UVicFH/PDU2019/Capture.JPG

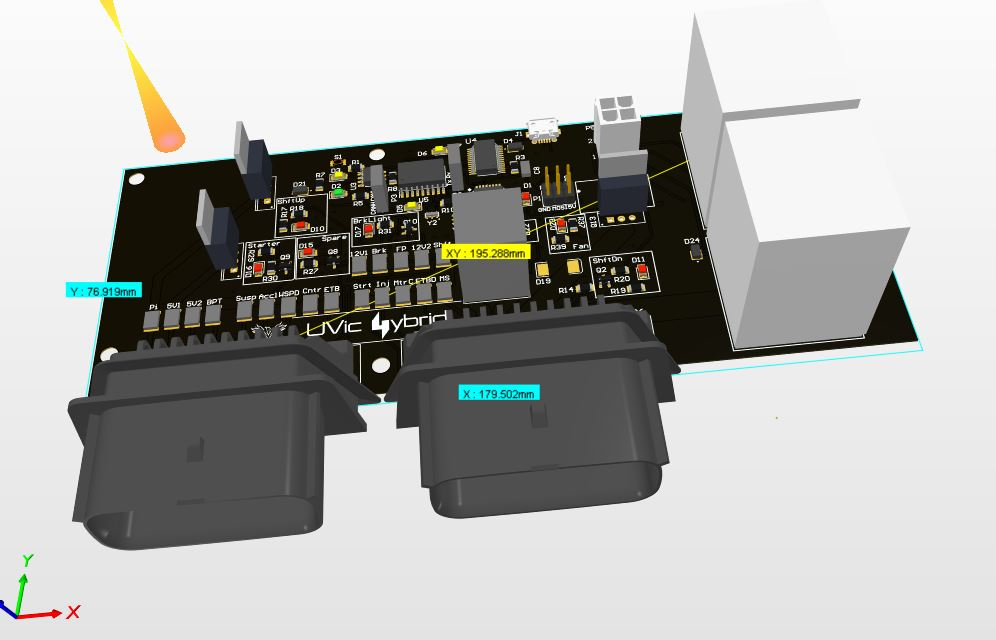
Capture.JPG
