UVicFH/PDU2019/README.md

# PDU2019
Power Distribution Unit for the 2019 vehichle
