UVicFH/PDU2019/Design Review 1 Akshdeep.rtf

PSCB file
some models are just grey boxes (fuses, relay?, caps)
mosfet models dont have legs
Green Molex?
USB has to be on edge of board for it will not sit right

High current switch
automotive relay with built in flyback diode?
does fuel pump need a flyback diode on output side?
Low current switch
the indicator leds say red on label, but part is for yellow ones (same on canduino)

Fusing
if multipe RBRB or CBRB pins are needed for current flow, the pins should be right next to one another, not spread out over two ocnnectors.
Same applies to the ground, keep it together on one connector
the layout for the connectors should be left undicided untill u make the pcb, you ma want to change the pinout to make wiring traces easier for yourself based on where you decide to put components.

IMPORTANT
The +5V net is used on the fusing and canduino files
That means that the components in the canduino are being powered before the fuse for it.
Change the +5V net in the canduino to a new net so the power flow is regulator > fuse > canduino diode > 5V
The Green led in canduino file for power indication is running at aprox 2.3mA, the resistor can be reduced a bit to bring this up to around 5-10mA.
