UVicFH/PDU2019/Power Distribution Unit 2019 BOM.xlsx

Comment | Description | Designator | Footprint | LibRef | Quantity | Supplier Part Number
1A | Fuse | 5VSpr1, 5VSpr2, 12VSpr1, 12VSpr2, BRKLTVIN, Cntrllr, ETBDrv, FP Rly, Inj, MS, Mtr Cntrl, Shft, Strt | FUSC4632X85N | Fuse 2 | 13 | 507-1878-1-ND
500mA | Fuse | ACCL, BPT, ETB, Susp, WSPD | FUSC4632X85N | Fuse 2 | 5 | 507-1876-1-ND
4.7uF | Capacitor (Semiconductor SIM Model) | C1, C5, C9, C17, C18, C19, C20 | CAPC3216X170N | Cap Semi | 7 | 1276-1055-1-ND
1uF | Capacitor (Semiconductor SIM Model) | C2, C10 | CAPC3216X170N | Cap Semi | 2 | 1276-3086-1-ND
100nF | Capacitor (Semiconductor SIM Model) | C3, C6, C7, C8 | CAPC3216X170N | Cap Semi | 4 | 1276-1151-1-ND
Cap2 | Capacitor. Ceramic 10uF 50V rating recommended, place close to pin | C4, C11, C12, C13, C14, C15, C16 | CAPC3216X170N | Cap2 | 7 | 478-8496-1-ND
Red | Typical RED LED | D1, D10, D11, D15, D16, D17, D22, D23 | LEDC3216X120NRED | LED2, LED2_2 | 8 | 732-4992-1-ND
Green | Typical GREEN LED | D2 | LEDC3216X120NGRN | LED2 | 1 | 732-4993-1-ND
Yellow | Typical YELLOW LED | D3, D5, D6, D7 | LEDC3216X120NYEL | LED2 | 4 | 732-4994-1-ND
Diode | Default Diode, Switching diode | D4, D18, D20, D21, D24 | DO-220AA | Diode | 5 | SS1P3L-M3/84AGICT-ND
Diode | Default Diode | D8, D9, D12, D13, D14 | SOD123 | Diode | 5 | BAT42W-FDICT-ND
Diode | Default Diode | D19 | SMC | Diode | 1 | S10D-TPMSCT-ND
Fuse 2 | Fuse | F1 | 1812 | Fuse 2 | 1 | ‎MF-MSMF050-2CT-ND
USB micro B | CONN SM TH USB MICRO MODIFIED FOR DRILL | J1 | 1050170001 | 1050170001 | 1 | 609-4618-1-ND
PB134012 | Miniature Power PCB Relay PB, 1 Form A Contact, 12 V, 10 A, 360 mW, Standard Version, -40 to 85 degC, 5-Pin 15 x 15 x 20 mm THD, RoHS, Tube | K1 | TECO-PB134-5_V | PB134012 | 1 | PB134012
Relay-3PDT | Reset relays | K2, K3 | 55.13 | Relay-3PDT | 2
ICSP | Header, 3-Pin, Dual row | P1 | Pin Header 2x3 TH Pitch 2.54mm | Header 3X2A | 1 | 952-2121-ND
Serial | Header, 2-Pin | P2 | Pin Header 1x2 TH Pitch 2.54mm | Header 2 | 1 | 952-2262-ND
CANOUT | Header, 2-Pin | P3 |  | Header 2 | 1 | 952-2262-ND
MX150-20 | Header, 10-Pin, Dual row | P4, P6 | MX150 20 PIN | Header 10X2 | 2 | WM12752-ND
43160-3102 | 4pin blade header molex | P5 | WM3801-ND | WM3801-ND | 1 | WM3801-ND
2A | Fuse | Pi | FUSC4632X85N | Fuse 2 | 1 | 507-1881-2-ND
MOSFET-N | N-Channel MOSFET | Q1, Q2, Q5, Q6, Q7, Q11, Q12 | SOT23-3 | MOSFET-N | 7 | SSM3K329RLFCT-ND
MOSFET-P | P-Channel MOSFET | Q3, Q4, Q8, Q9, Q10 | SOT23-3 | MOSFET-P | 5 | DMP3099L-7DICT-ND
MOSFET-P | P-Channel MOSFET | Q13 | TO-220AB | MOSFET-P | 1 | IRF4905PBF-ND
10K | Resistor | R1, R9 | RESC3216X60N | Res1 | 2 | RNCP1206FTD10K0CT-ND
1K | Resistor | R2, R3, R4, R7, R10, R11, R12, R15, R16, R24, R25, R26 | RESC3216X60N | Res1 | 12 | RMCF1206FT1K00CT-ND, RNCP1206FTD1K00CT-ND
499 | Resistor | R5 | RESC3216X60N | Res1 | 1 | RMCF1206FT499RCT-ND
16.9K | Resistor | R6 | RESC3216X60N | Res1 | 1 | RMCF1206FT16K9CT-ND
120 | Resistor | R8 | RESC3216X60N | Res1 | 1 | CRCW1206120RFKEAHPTR-ND
1206 | Resistor | R13, R14, R18, R20, R21, R22, R23, R28, R30, R32, R35, R36, R37 | RESC3216X60N | Res1 | 13 | RHM1.0MPCT-ND
511 | Resistor | R17, R19, R27, R29, R31, R38, R39 | RESC3216X60N | Res1 | 7 | RNCP1206FTD511RCT-ND
1.4K | Resistor | R33, R34 | RESC3216X60N | Res1 | 2 | 541-1.40KFCT-ND
SW-PB | Switch | S1 | SMDswitch_1206 | SW-PB | 1 | CKN10779CT-ND
ATmega328P-AU | 8-bit AVR Microcontroller, 32KB Flash, 1KB EEPROM, 2KB SRAM, 32-pin TQFP, Industrial Grade (-40°C to 85°C) | U1 | QFP80P900X900X120-32N | ATmega328P-AU | 1 | ATMEGA328P-AU-ND
LM1085IT-5.0/NOPB | 3A Low Dropout Positive Regulators, 3-pin TO-220, Pb-Free | U2, U6 | T03B | LM1085IT-5.0/NOPB | 2 | LM1085IT-5.0/NOPB
MCP2551-E/SN | SOIC | U3 | SOIC127P600X175-8N | MCP2551-E/SN | 1 | MCP2551T-E/SNCT-ND
FT232RL-Reel | USB UART Asynchronous Serial Data Transfer Chip, SSOP-28, Tape and Reel | U4 | SOP65P780X200-28N | FT232RL-Reel | 1 | 768-1007-1-ND
MCP2515-E/ST | SOIC | U5 | SOIC127P1030X265-18N | MCP2515-E/ST | 1 | MCP2515T-I/SOCT-ND
CSTCE16M0V53-R0 |  | Y1, Y2 | CSTCE_G | CSTCE16M0V53-R0 | 2 | 490-17948-1-ND
Heatsink for MOSFET |  |  |  |  | 1 | HS115-ND
Heatsink for Lin Reg.
Total: |  |  |  |  | 136
