UVicFH/PDU2019/DO214AB Model/DO-214AB.STEP

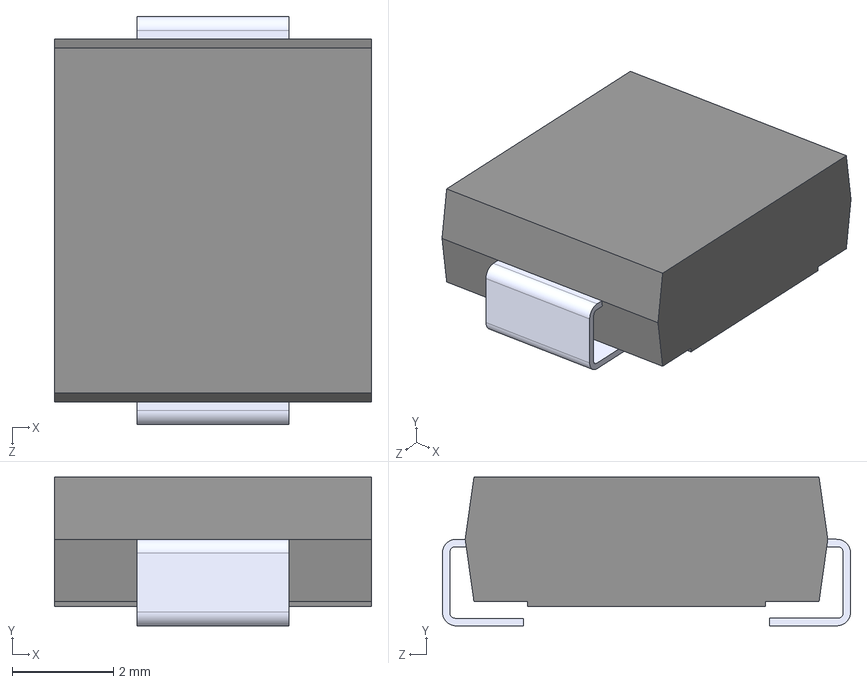
[picture p4: CAD file, 2018-10-21]
DO214AB Model/DO-214AB.STEP
6.25 x 2.93 x 8.05 mm
