UVicFH/PDU2019/MX150 Model/348302001.stp

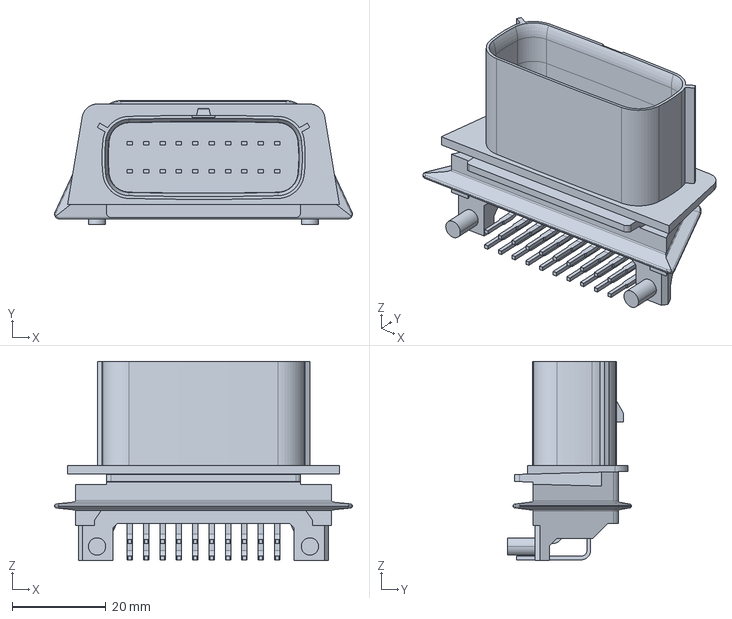
[picture p5: CAD file, 2018-10-21]
MX150 Model/348302001.stp
63.7 x 26.5 x 42.6 mm
