UVicFH/PDU2019/039281043.stp

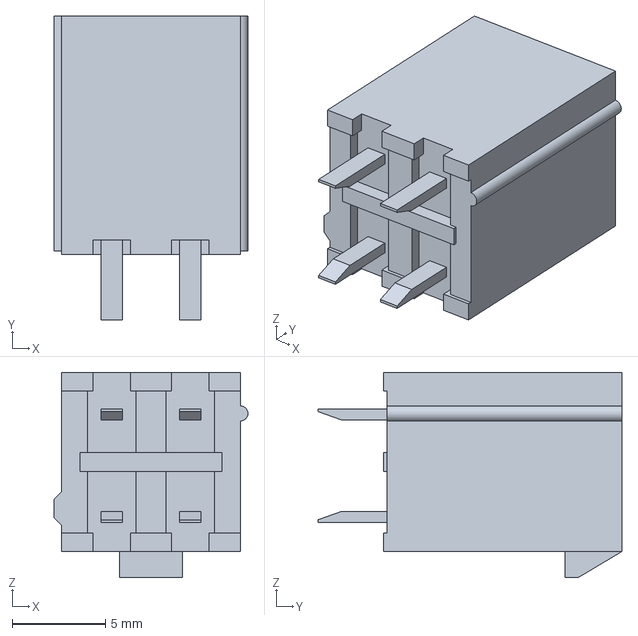
[picture p6: CAD file, 2018-12-19]
039281043.stp
10.4 x 16.3 x 11.0 mm
