UVicFH/PDU2019/(list of files, cad)

Other CAD files:
PowerDist.DWG
