UVicFH/PDU2019/(list of files, drawings)

Other design files:
5VPower.SchDoc
12VPower.SchDoc
Candunio.SchDoc
FullFuseSchem.SchDoc
Fusing.SchDoc
HighCurrentSwitches.SchDoc
LowCurrentSwitches.SchDoc
Power Distribution Unit 2019.PrjPCB
Power Distribution Unit 20191/Power Distribution Unit 2019.SCHLIB
Power Distribution Unit 20191/PowerDist1.PcbLib
Power Distribution Unit 20192/Power Distribution Unit 2019.SCHLIB
Power Distribution Unit 20192/PowerDist1.PcbLib
PowerDist1.PcbLib
PowerDist.PcbDoc
PowerDistLib.PcbLib
PowerDistLib.SchLib
ResetCircuit.SchDoc
Switches.SchDoc
