UVicFH/PDU2019/(commit log)

2018-07-16 Created Project for PDU
    Added files
    [Candunio.SchDoc, Power Distribution Unit 2019.PrjPCB]
2018-08-11 Added Voltage Regulator and Updated CANDuino files
    [1206SMDswitch.PcbLib, 12VPower.SchDoc, 5VPower.SchDoc, Candunio v2018_8_7.SCHLIB, Candunio.PcbLib, Candunio.SchDoc, ResetCircuit.SchDoc, UVICHybridLibrary.SchLib]
2018-08-12 Fixed Regulator, Added dedicated PDU Library
    [1206SMDswitch.PcbLib, 5VPower.SchDoc, Candunio v2018_8_7.SCHLIB, Candunio.PcbLib, PowerDistLib.PcbLib, PowerDistLib.SchLib, UVICHybridLibrary.SchLib, UVICHyrbidLibrary (1).PcbLib]
2018-08-22 updated library and schem
    [5VPower.SchDoc, PowerDistLib.PcbLib, PowerDistLib.SchLib]
2018-08-30 rbrb fusing added
    [12VPower.SchDoc, 5VPower.SchDoc, Candunio.SchDoc]
2018-08-30 CBRB Fusing Added
    [12VPower.SchDoc]
2018-09-05 fuse stuff
    [12VPower.SchDoc]
2018-09-05 fue stuff
    [ResetCircuit.SchDoc]
2018-09-07 Fusing, Switching etc...
    [12VPower.SchDoc, 5VPower.SchDoc, Candunio.SchDoc, Fusing.SchDoc, HighCurrentSwitches.SchDoc, LowCurrentSwitches.SchDoc, Power Distribution Unit 2019.PrjPCB, PowerDistLib.PcbLib]
2018-09-07 moved a resistor
    [Fusing.SchDoc, HighCurrentSwitches.SchDoc, LowCurrentSwitches.SchDoc, Power Distribution Unit 2019.PrjPCB, ResetCircuit.SchDoc]
2018-09-11 changed out relay schem/footprint
    [HighCurrentSwitches.SchDoc, PowerDistLib.PcbLib, PowerDistLib.SchLib]
2018-10-06 Connectors/Fusing Edits
    [FullFuseSchem.SchDoc, Fusing.SchDoc, HighCurrentSwitches.SchDoc, LowCurrentSwitches.SchDoc, ResetCircuit.SchDoc]
2018-10-09 Footprints & 3D models added
    [Fusing.SchDoc, HighCurrentSwitches.SchDoc, LowCurrentSwitches.SchDoc, Power Distribution Unit 2019.PrjPCB, PowerDistLib.PcbLib, PowerDistLib.SchLib, ResetCircuit.SchDoc]
2018-10-16 PCB Created
    [Candunio.SchDoc, Fusing.SchDoc, HighCurrentSwitches.SchDoc, LowCurrentSwitches.SchDoc, Power Distribution Unit 2019.PrjPCB, PowerDist.PcbDoc, PowerDistLib.PcbLib]
2018-10-21 PCB Updated
    [Candunio.SchDoc, Fusing.SchDoc, PowerDist.PcbDoc, PowerDistLib.PcbLib]
2018-10-21 MX150 Model Added
    [348302001.stp, Candunio.SchDoc, DO-214AB.STEP, Fusing.SchDoc, HighCurrentSwitches.SchDoc, LowCurrentSwitches.SchDoc, PowerDist.PcbDoc, PowerDistLib.PcbLib]
2018-10-29 PCB Layout Updated
    [Candunio.SchDoc, Fusing.SchDoc, PowerDist.PcbDoc]
2018-11-04 layout update
    [PowerDist.PcbDoc]
2018-11-08 Gnd planes, holes and other fun stuff
    [Candunio.SchDoc, Fusing.SchDoc, HighCurrentSwitches.SchDoc, PowerDist.PcbDoc, PowerDistLib.PcbLib]
2018-11-16 Started Routing
    [Candunio.SchDoc, HighCurrentSwitches.SchDoc, LowCurrentSwitches.SchDoc]
2018-11-16 des rev
2018-11-16 Better Integrated Library
    [Fusing.SchDoc]
2018-11-17 Added Connector for Rst Cct
    [Fusing.SchDoc, Power Distribution Unit 2019.PrjPCB, PowerDist.PcbDoc, PowerDistLib.PcbLib, PowerDistLib.SchLib]
2018-11-23 pinout changed
    [Candunio.SchDoc, Fusing.SchDoc, LowCurrentSwitches.SchDoc, Power Distribution Unit 2019.PrjPCB, PowerDistLib.PcbLib, PowerDistLib.SchLib]
2018-11-23 connection change
    [Fusing.SchDoc]
2018-11-25 up to date
    [Candunio.SchDoc, Fusing.SchDoc, LowCurrentSwitches.SchDoc, Power Distribution Unit 2019.PrjPCB, Power Distribution Unit 2019.SCHLIB, PowerDist1.PcbLib, PowerDistLib.PcbLib]
2018-11-25 Routing Done
    [Candunio.SchDoc, Fusing.SchDoc, HighCurrentSwitches.SchDoc, LowCurrentSwitches.SchDoc]
2018-11-25 All traces routed
2018-12-05 Design Review Updates
    Still need to add in reset circuit
    [Candunio.SchDoc, Fusing.SchDoc, HighCurrentSwitches.SchDoc, LowCurrentSwitches.SchDoc, Power Distribution Unit 2019.PrjPCB, PowerDist.xlsx]
2018-12-13 Added Reset Circuit
    [Candunio.SchDoc, Fusing.SchDoc, Power Distribution Unit 2019.PrjPCB, PowerDistLib.PcbLib, ResetCircuit.SchDoc]
2018-12-14 BOM Added
    [HighCurrentSwitches.SchDoc, LowCurrentSwitches.SchDoc, Power Distribution Unit 2019 BOM.xlsx, Power Distribution Unit 2019.PrjPCB, Power Distribution Unit 2019.xlsx, PowerDist.xlsx]
2019-01-04 Finalized board
    one missing connection, simplified a bit, design rule check and fixed minor things
    [Candunio.SchDoc, Fusing.SchDoc, HighCurrentSwitches.SchDoc, LowCurrentSwitches.SchDoc, Power Distribution Unit 2019.PrjPCB, ResetCircuit.SchDoc]
2019-01-07 Fixed footprint for mosfets
    P and N channel switching mosfet footprints were incorrect with respect to schematic symbol, flipping gate and source
    [Fusing.SchDoc, HighCurrentSwitches.SchDoc, LowCurrentSwitches.SchDoc, Power Distribution Unit 2019 BOM.xlsx, Power Distribution Unit 2019.PrjPCB, Power Distribution Unit 2019.SCHLIB, PowerDist1.PcbLib, ResetCircuit.SchDoc]
2019-01-07 routed fixed footprints
2019-01-08 updated integrated library with fixed footprint
    [HighCurrentSwitches.SchDoc, LowCurrentSwitches.SchDoc, Power Distribution Unit 2019.PrjPCB]
2019-01-08 missed on last push
    [HighCurrentSwitches.SchDoc]
2019-01-09 fixed numbering for mosfets
    mosfets should now line up between symbol, footprint, and pin mapping. 1-D, 2-G, 3-S. polarized caps still need a polarized footprint that is marked
    [HighCurrentSwitches.SchDoc, LowCurrentSwitches.SchDoc, PowerDist1.PcbLib]
2019-01-10 Polarized Cao Footprint Updated
    Updated polarized cap footprint. Reconfigured regulator position to allow more room for heatsink
    [Fusing.SchDoc, LowCurrentSwitches.SchDoc, PowerDist1.PcbLib]
2019-01-10 changes for order
    [Candunio.SchDoc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]
2019-02-15 added code
    [PowerDist.DWG]
2019-03-11 changed CAN ID
    switched from testing ID to car ID
2019-03-24 Update PDU_2019.ino
    Added delay in can send (20hz now)
    - Jules
2019-03-31 removed fan PWM
    fan on or off
2019-03-31 Update PDU_2019.ino
    added digital fan control with hystreisis
2019-03-31 Adjusted PWM frequency
2019-04-02 PWM Frequency library included
    freq changed to 20kHz
2019-04-04 Hysteresis added for Fan
2019-04-12 Updated CAN messages
    Shortened the input and output datafield length
    [PDU_2019.ino, Pin_Defines.h]
2020-02-21 Competition code for pdu
    This is the code that was on the pdu at comp. No pwm, ids 80 and 81 for CAN
2020-02-21 Double check the right thing made it through the filter
